GSTL-ITU/HORNET-RV32IMF/docs/figures/bootloader.pdf

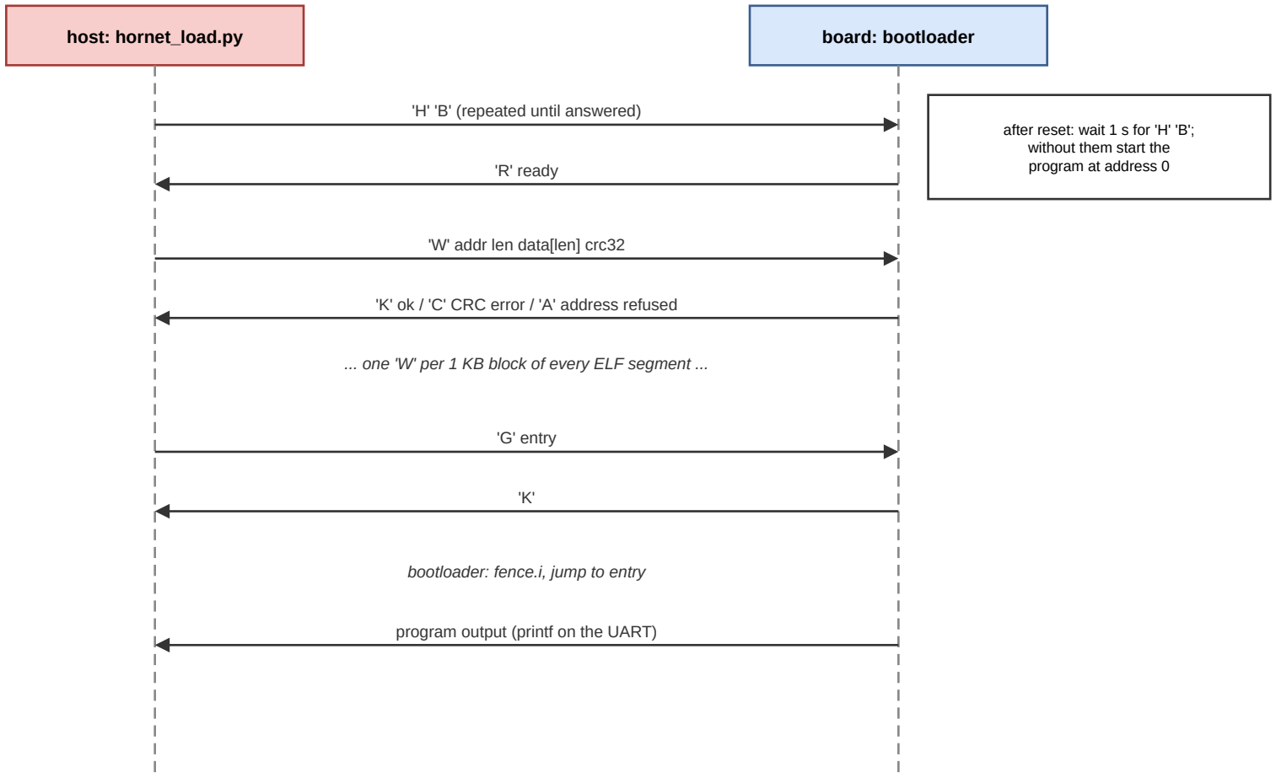
[picture p1: figure]
host: hornet_load.py; board: bootloader; 'H' 'B' (repeated until answered); 'R' ready; 'W' addr len data[len] crc32; 'G' entry; bootloader: fence.i, jump to entry; program output (printf on the UART); after reset: wait 1 s for 'H' 'B'; without them start the program at address 0

'K' ok / 'C' CRC error / 'A' address refused

... one 'W' per 1 KB block of every ELF segment ...
