GSTL-ITU/HORNET-RV32IMF/docs/figures/bus.pdf

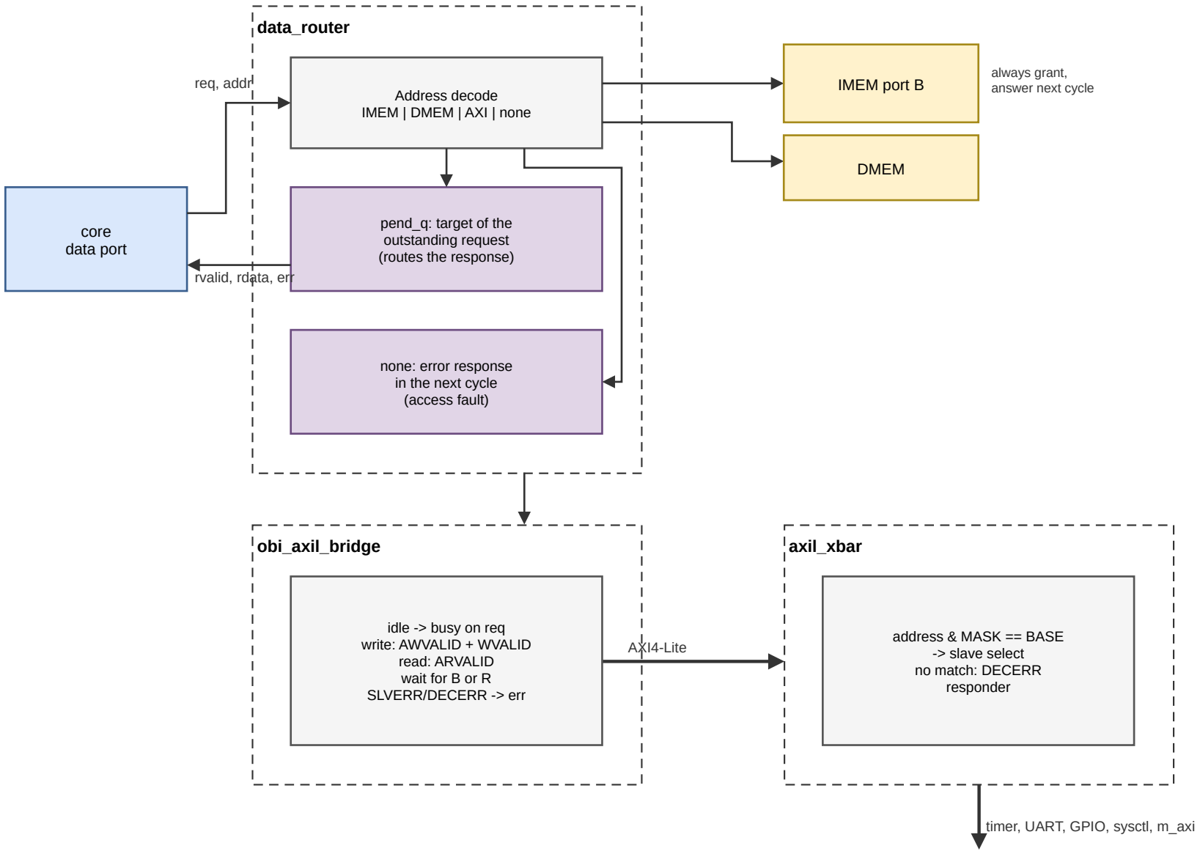
[picture p2: figure]
core data port; data_router; Address decode IMEM | DMEM | AXI | none; pend_q: target of the outstanding request (routes the response); none: error response in the next cycle (access fault); req, addr; rvalid, rdata, err; IMEM port B; DMEM; always grant, answer next cycle; obi_axil_bridge; idle -> busy on req write: AWVALID + WVALID read: ARVALID wait for B or R SLVERR/DECERR -> err; AXI4-Lite; axil_xbar; address & MASK == BASE -> slave select no match: DECERR responder; timer, UART, GPIO, sysctl, m_axi
