GSTL-ITU/HORNET-RV32IMF/docs/figures/cosim.pdf

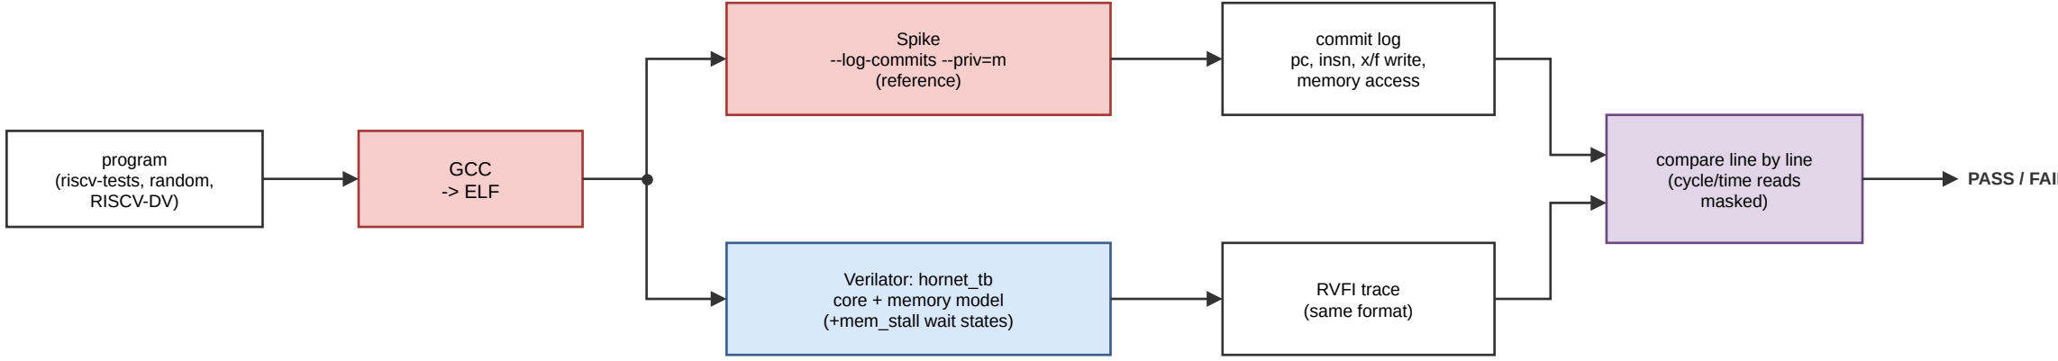
[picture p3: figure]
ris; m, RISCV-DV); pik; mit; riv; rila; el (+mem_stall wait states ); mit lo; rit; e lin; y lin; cle; tim

# e, memory access RVFI trace (same format)

I

L
