GSTL-ITU/HORNET-RV32IMF/docs/figures/memmap.pdf

IMEM (IMEM_SIZE)
.text, .rodata; bootloader in the top 4 KB

0x0000_0000

unmapped: access fault

DMEM (DMEM_SIZE)
.data, .sdata, .bss, heap, stack (top)

0x1000_0000

unmapped: access fault

timer (CLINT): msip, mtimecmp, mtime

0x2000_0000

UART: DATA, STATUS, CTRL, DIV

0x2001_0000

GPIO: OUT, IN, DIR, IE, IP, EDGE

0x2002_0000

system control: EXIT, CLK_FREQ, ID, SCRATCH

0x2003_0000

unmapped: DECERR -> access fault

external AXI4-Lite port (m_axi) up to 0x7FFF_FFFF

0x4000_0000

unmapped: access fault
0xFFFF_FFFF

instruction port: IMEM only data port: everything
