GSTL-ITU/HORNET-RV32IMF/docs/figures/swflow.pdf

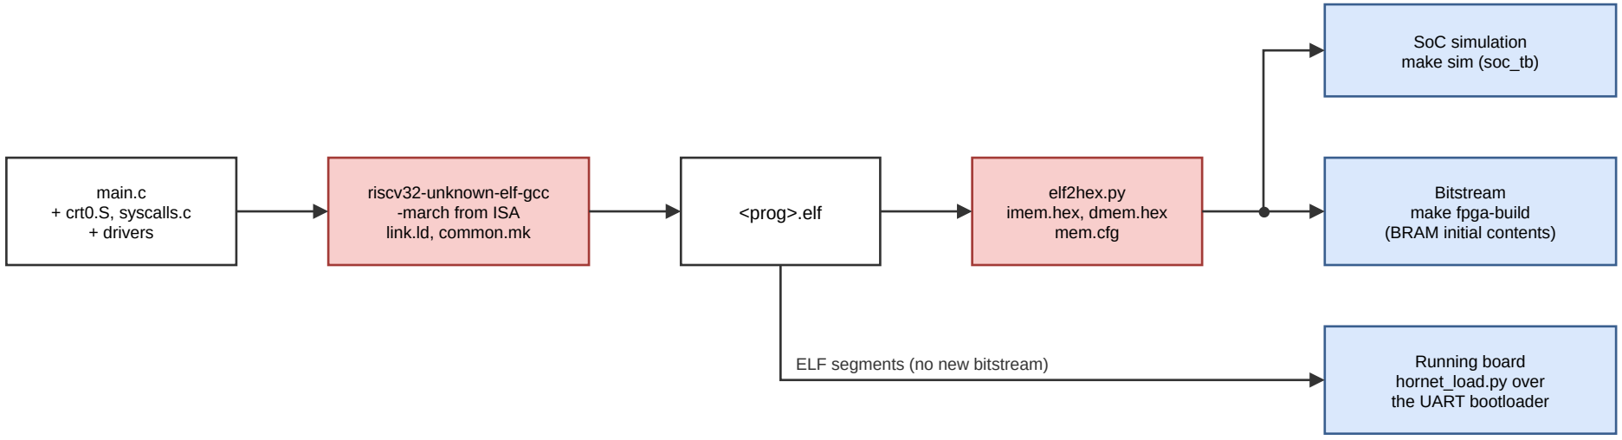
[picture p4: figure]
main.c + crt0.S, syscalls.c + drivers; riscv32-unknown-elf-gcc -march from ISA link.ld, common.mk; <prog>.elf; elf2hex.py imem.hex, dmem.hex mem.cfg; SoC simulation make sim (soc_tb); Bitstream make fpga-build (BRAM initial contents); Running board hornet_load.py over the UART bootloader; ELF segments (no new bitstream)
