GSTL-ITU/HORNET-RV32IMF/docs/figures/decode.pdf

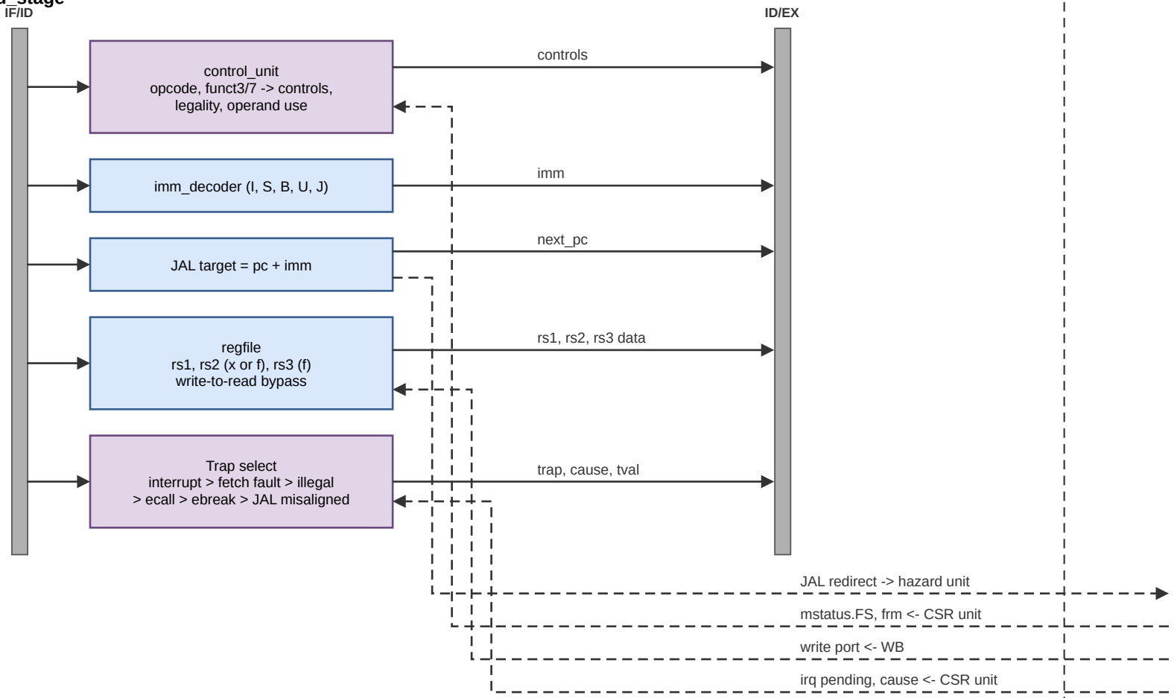
[picture p5: figure]
control_unit opcode, funct3/7 -> controls, legality, operand use; imm_decoder (I, S, B, U, J); JAL target = pc + imm; regfile rs1, rs2 (x or f), rs3 (f) write-to-read bypass; Trap select interrupt > fetch fault > illegal > ecall > ebreak > JAL misaligned; controls; imm; next_pc; rs1, rs2, rs3 data; trap, cause, tval; JAL redirect -> hazard unit; mstatus.FS, frm <- CSR unit; write port <- WB; irq pending, cause <- CSR unit

### id_stage
