GSTL-ITU/HORNET-RV32IMF/docs/figures/divider.pdf

### div (radix-2 restoring divider)

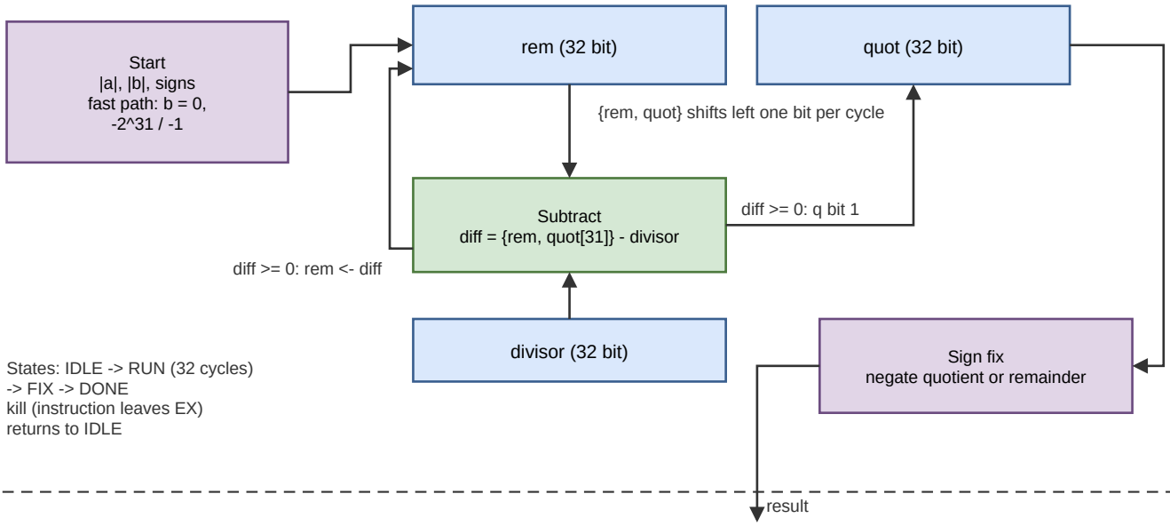
[picture p6: figure]
Start |a|, |b|, signs fast path: b = 0, -2^31 / -1; rem (32 bit); quot (32 bit); Subtract diff = {rem, quot[31]} - divisor; divisor (32 bit); diff >= 0: q bit 1; diff >= 0: rem <- diff; Sign fix negate quotient or remainder; result; States: IDLE -> RUN (32 cycles) -> FIX -> DONE kill (instruction leaves EX) returns to IDLE

{rem, quot} shifts left one bit per cycle
