GSTL-ITU/HORNET-RV32IMF/docs/figures/divsqrt.pdf

### fpu_divsqrt

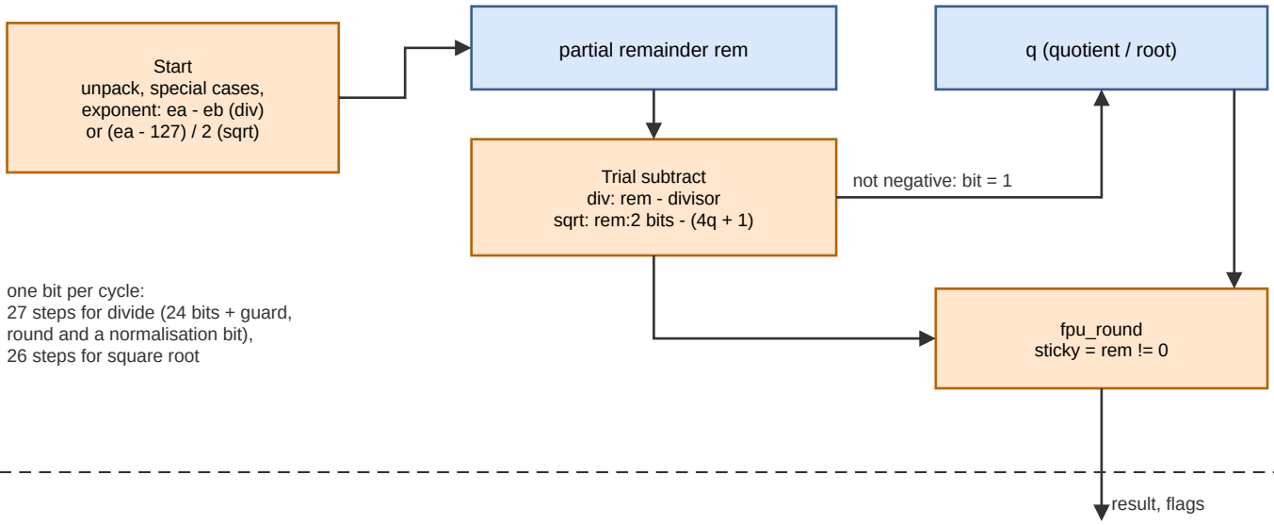
[picture p7: figure]
Start unpack, special cases, exponent: ea - eb (div) or (ea - 127) / 2 (sqrt); partial remainder rem; Trial subtract div: rem - divisor sqrt: rem:2 bits - (4q + 1); q (quotient / root); not negative: bit = 1; fpu_round sticky = rem != 0; result, flags; one bit per cycle: 27 steps for divide (24 bits + guard, round and a normalisation bit), 26 steps for square root
