GSTL-ITU/HORNET-RV32IMF/docs/figures/fma.pdf

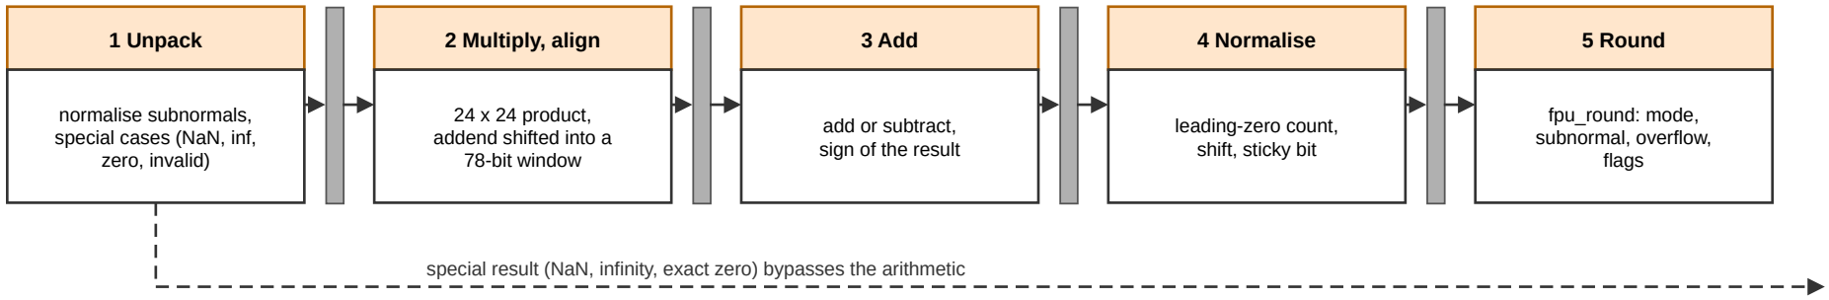
[picture p8: figure]
1 Unpack; normalise subnormals, special cases (NaN, inf, zero, invalid); 2 Multiply, align; 24 x 24 product, addend shifted into a 78-bit window; 3 Add; add or subtract, sign of the result; 4 Normalise; leading-zero count, shift, sticky bit; 5 Round; fpu_round: mode, subnormal, overflow, flags

special result (NaN, infinity, exact zero) bypasses the arithmetic op mapping: FADD a*1+b, FSUB a*1-b, FMUL a*b+(±0), FMADD a*b+c, FMSUB a*b-c, FNMSUB -a*b+c, FNMADD -a*b-c
