GSTL-ITU/HORNET-RV32IMF/docs/figures/periph.pdf

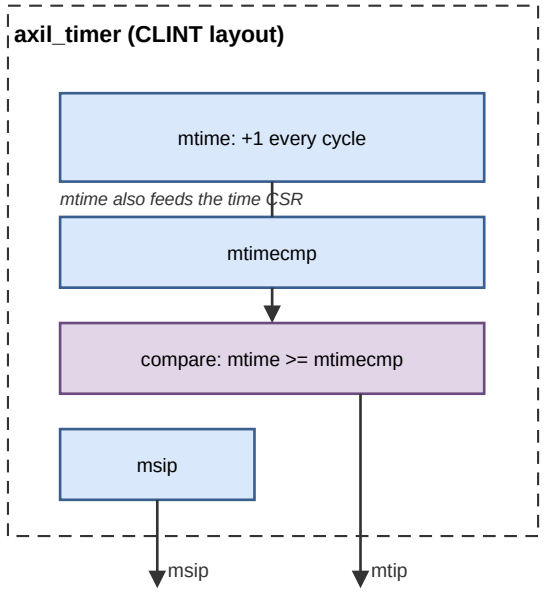
[picture p9: figure]
axil_timer (CLINT layout); mtime: +1 every cycle; mtimecmp; compare: mtime >= mtimecmp; msip; mtip; mtime also feeds the time CSR
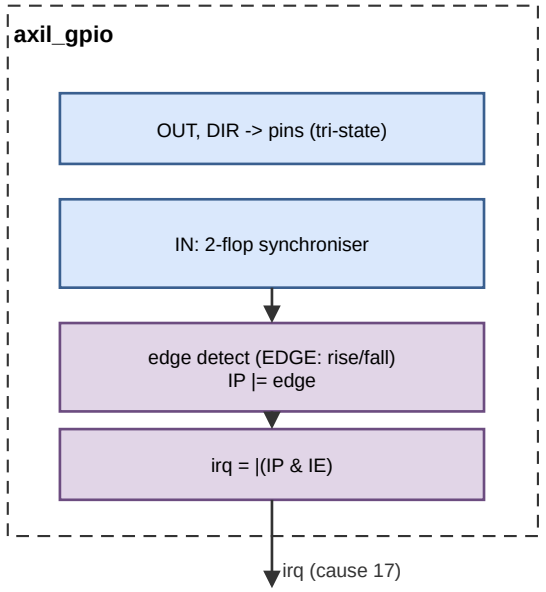
[picture p10: figure]
axil_gpio; OUT, DIR -> pins (tri-state); IN: 2-flop synchroniser; edge detect (EDGE: rise/fall) IP |= edge; irq = |(IP & IE); irq (cause 17)

axil_sysctl

EXIT -> exit_o, exit_code

CLK_FREQ (parameter)

ID = 0x4852_4E54 "HRNT"

SCRATCH
