GSTL-ITU/HORNET-RV32IMF/docs/manual.md

---
orphan: true
---

<!-- Root of the HORNET manual: Part I of the student's manual (make docs).
     The chapter list is the same as Part I in index.md. -->

# HORNET RV32IMF manual

```{toctree}
:maxdepth: 2
:numbered:

introduction
quick-start
repository
soc
core
programming
peripherals
software
fpga
verification
reference
references
```
