GSTL-ITU/HORNET-RV32IMF/docs/figures/blockdesign.pdf

### bd_demo (Vivado block design)

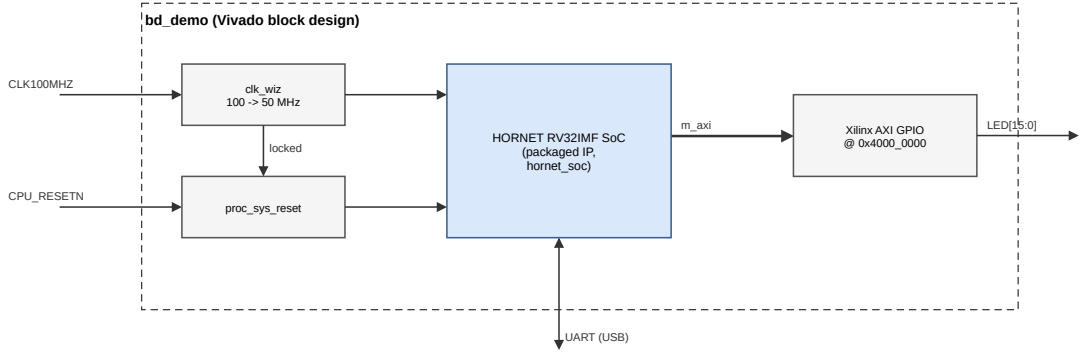
[picture p11: page 1]
clk_wiz 100 -> 50 MHz; proc_sys_reset; HORNET RV32IMF SoC (packaged IP, hornet_soc); locked; m_axi; LED[15:0]; UART (USB); CLK100MHZ; CPU_RESETN

Xilinx AXI GPIO
