GSTL-ITU/HORNET-RV32IMF/docs/figures/testbenches.pdf

t

b

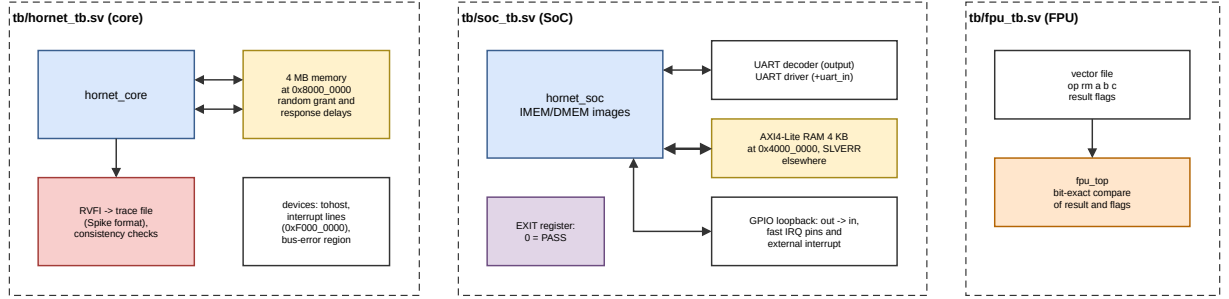
[picture p12: page 1]
ela; file; pik; ), consistency chec k; vic; t, interrupt lines; riv; Lit; els; PIO lo; XIT; gis; r: 0 = PASS; ult; fla; bit

c IMEM/DMEM im

> in, fast IRQ pins and external interrupt

), bus-error region
