GSTL-ITU/HORNET-RV32IMF/docs/figures/board.pdf

### hornet_board (FPGA top)

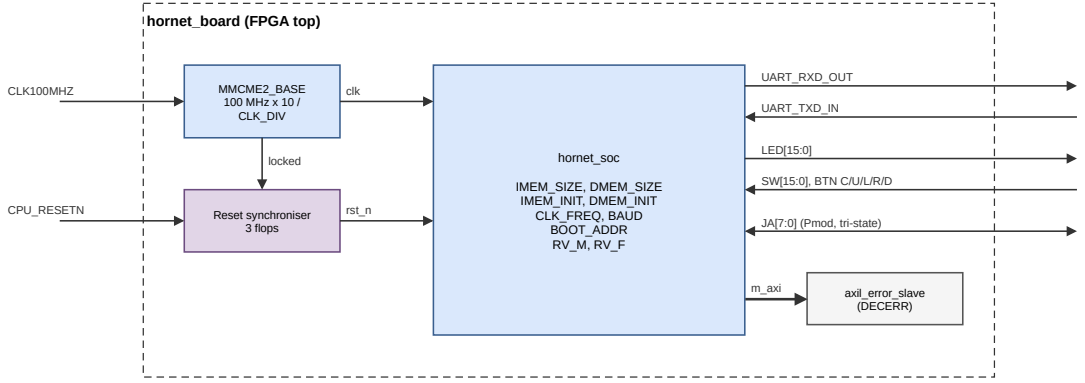
[picture p13: page 1]
MMCME2_BASE 100 MHz x 10 / CLK_DIV; CLK100MHZ; Reset synchroniser 3 flops; CPU_RESETN; locked; hornet_soc; IMEM_SIZE, DMEM_SIZE IMEM_INIT, DMEM_INIT CLK_FREQ, BAUD BOOT_ADDR RV_M, RV_F; clk; rst_n; axil_error_slave (DECERR); m_axi; UART_RXD_OUT; UART_TXD_IN; LED[15:0]; SW[15:0], BTN C/U/L/R/D

JA[7:0] (Pmod, tri-state)
