GSTL-ITU/HORNET-RV32IMF/docs/figures/fetch.pdf

### if_stage

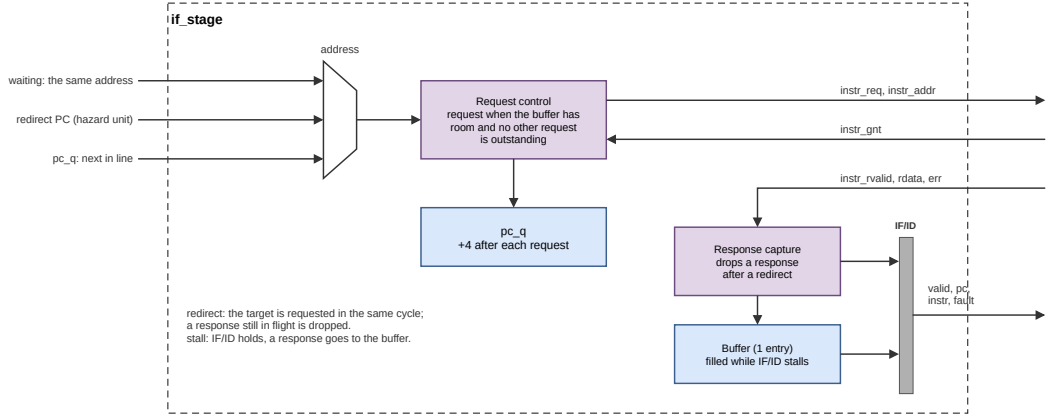
[picture p14: page 1]
address; instr_req, instr_addr; instr_gnt; +4 after each request; Response capture; drops a response after a redirect; instr_rvalid, rdata, err; valid, pc, instr, fault

waiting: the same address

Request control
request when the buffer has
room and no other request
is outstanding

redirect PC (hazard unit)

pc_q: next in line

redirect: the target is requested in the same cycle;
a response still in flight is dropped.
stall: IF/ID holds, a response goes to the buffer.

Buffer (1 entry)
filled while IF/ID stalls
