GSTL-ITU/HORNET-RV32IMF/docs/figures/pipeline.pdf

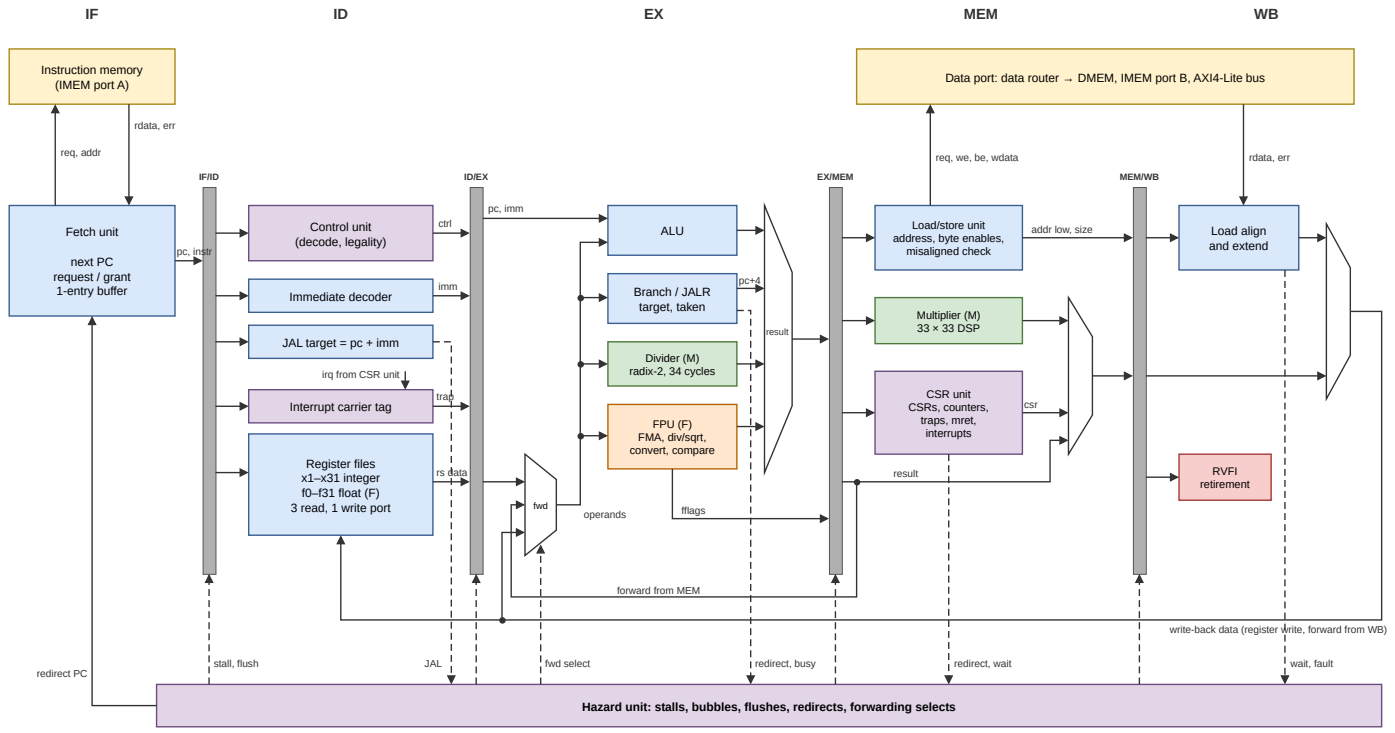
[picture p15: page 1]
MEM; Instruction memory (IMEM port A); Fetch unit; next PC request / grant 1-entry buffer; req, addr; rdata, err; pc, instr; Control unit (decode, legality); Immediate decoder; ctrl; imm; trap; rs data; fwd; ALU; Branch / JALR target, taken; Divider (M) radix-2, 34 cycles; pc, imm; operands; result; EX/MEM; fflags; redirect, busy; Multiplier (M) 33 × 33 DSP; CSR unit CSRs, counters, traps, mret, interrupts; csr; MEM/WB; redirect, wait; Load align and extend; RVFI retirement; wait, fault; JAL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

Data port: data router → DMEM, IMEM port B, AXI4-Lite bus

req, we, be, wdata

Load/store unit
address, byte enables,
misaligned check

addr low, size

JAL target = pc + imm

irq from CSR unit

Interrupt carrier tag

FPU (F)
FMA, div/sqrt,
convert, compare

Register files
x1–x31 integer
f0–f31 float (F)
3 read, 1 write port

forward from MEM

write-back data (register write, forward from WB)

Hazard unit: stalls, bubbles, flushes, redirects, forwarding selects
