GSTL-ITU/HORNET-RV32IMF/docs/figures/riscvdv.pdf

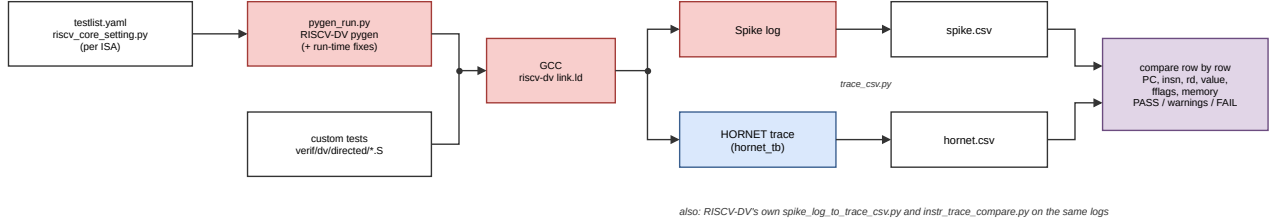
[picture p16: page 1]
testlist.yaml riscv_core_setting.py (per ISA); Spike log; HORNET trace (hornet_tb); spike.csv; hornet.csv; trace_csv.py

pygen_run.py
RISCV-DV pygen
(+ run-time fixes)

GCC
riscv-dv link.ld

compare row by row
PC, insn, rd, value,
fflags, memory
PASS / warnings / FAIL

custom tests
verif/dv/directed/*.S

also: RISCV-DV's own spike_log_to_trace_csv.py and instr_trace_compare.py on the same logs
