GSTL-ITU/HORNET-RV32IMF/docs/figures/soc.pdf

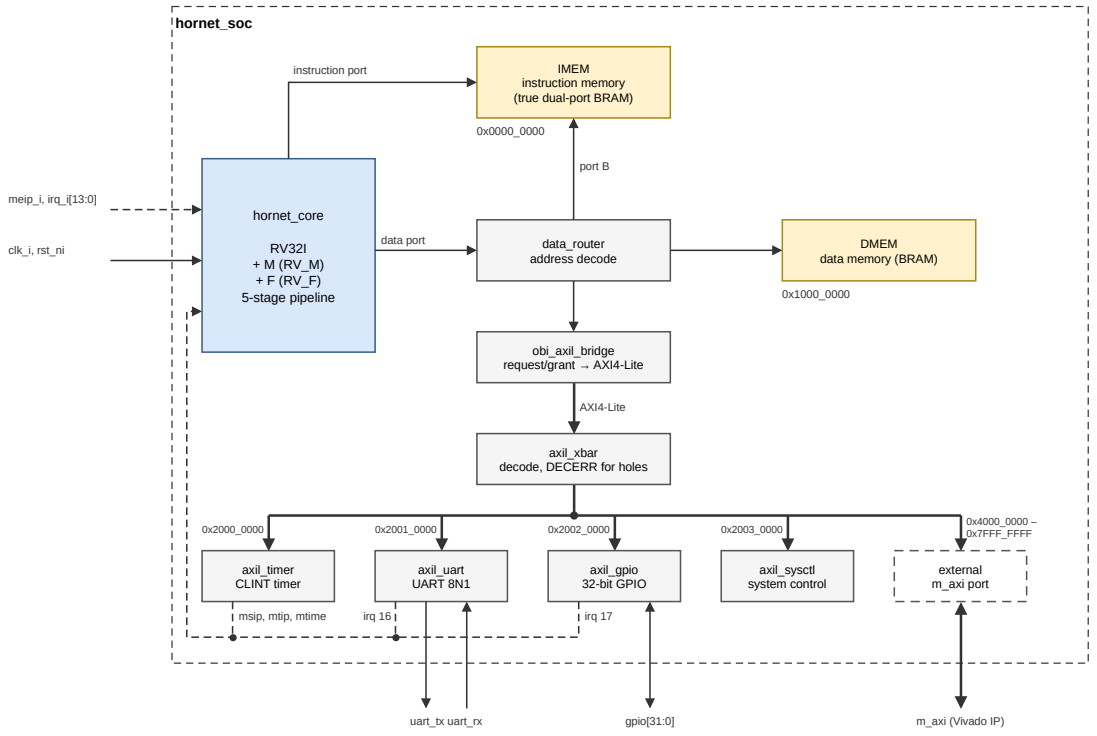
[picture p17: page 1]
hornet_soc; hornet_core; RV32I + M (RV_M) + F (RV_F) 5-stage pipeline; instruction port; data_router address decode; data port; port B; axil_xbar; AXI4-Lite; axil_timer CLINT timer; axil_uart UART 8N1; axil_gpio 32-bit GPIO; axil_sysctl system control; external m_axi port; uart_tx uart_rx; gpio[31:0]; m_axi (Vivado IP); msip, mtip, mtime; irq 16; irq 17; meip_i, irq_i[13:0]; clk_i, rst_ni; 0x4000_0000 – 0x7FFF_FFFF

IMEM
instruction memory
(true dual-port BRAM)

DMEM
data memory (BRAM)

obi_axil_bridge
request/grant → AXI4-Lite

decode, DECERR for holes
