GSTL-ITU/HORNET-RV32IMF/docs/figures/uart.pdf

### axil_uart

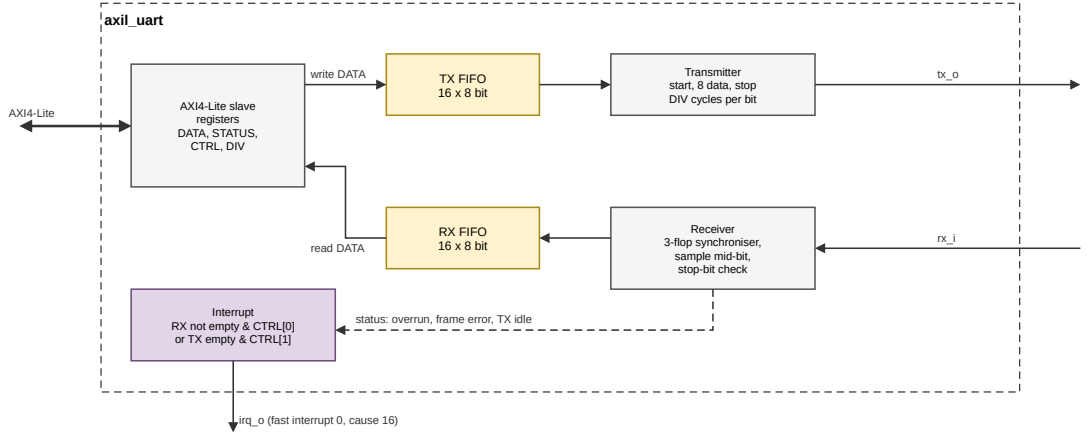
[picture p19: page 1]
AXI4-Lite slave registers DATA, STATUS, CTRL, DIV; AXI4-Lite; TX FIFO 16 x 8 bit; write DATA; RX FIFO 16 x 8 bit; read DATA; Interrupt

Transmitter
start, 8 data, stop
DIV cycles per bit

Receiver
3-flop synchroniser,
sample mid-bit,
stop-bit check

status: overrun, frame error, TX idle

RX not empty & CTRL[0]
or TX empty & CTRL[1]

irq_o (fast interrupt 0, cause 16)
