GSTL-ITU/HORNET-RV32IMF/docs/figures/core_rv32i.pdf

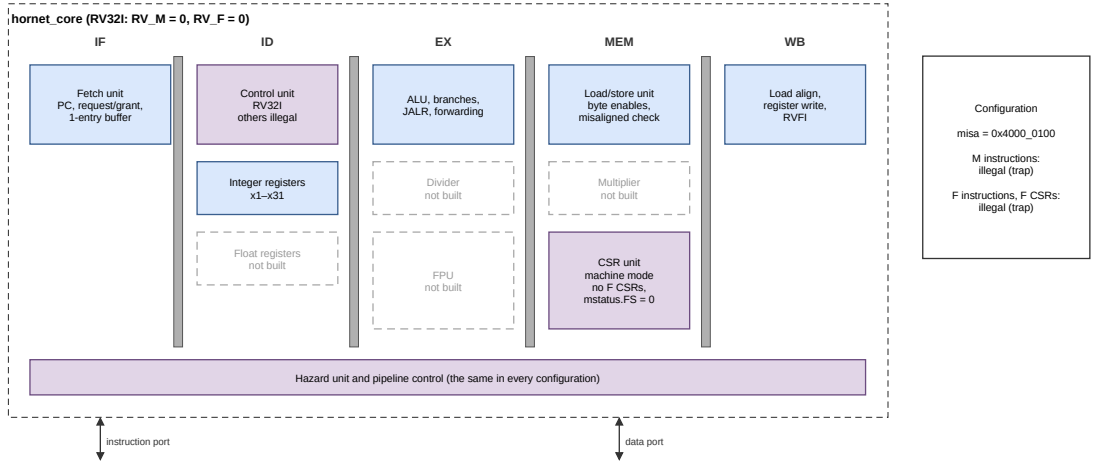
[picture p20: page 1]
hornet_core (RV32I: RV_M = 0, RV_F = 0); MEM; Control unit RV32I others illegal; Integer registers x1–x31; Float registers not built; ALU, branches, JALR, forwarding; Divider not built; FPU not built; Multiplier not built; CSR unit machine mode no F CSRs, mstatus.FS = 0; Load align, register write, RVFI; Configuration; misa = 0x4000_0100; M instructions: illegal (trap); F instructions, F CSRs: illegal (trap); instruction port; data port

Fetch unit
PC, request/grant,
1-entry buffer

Load/store unit
byte enables,
misaligned check

Hazard unit and pipeline control (the same in every configuration)
