GSTL-ITU/HORNET-RV32IMF/docs/figures/core_rv32imf.pdf

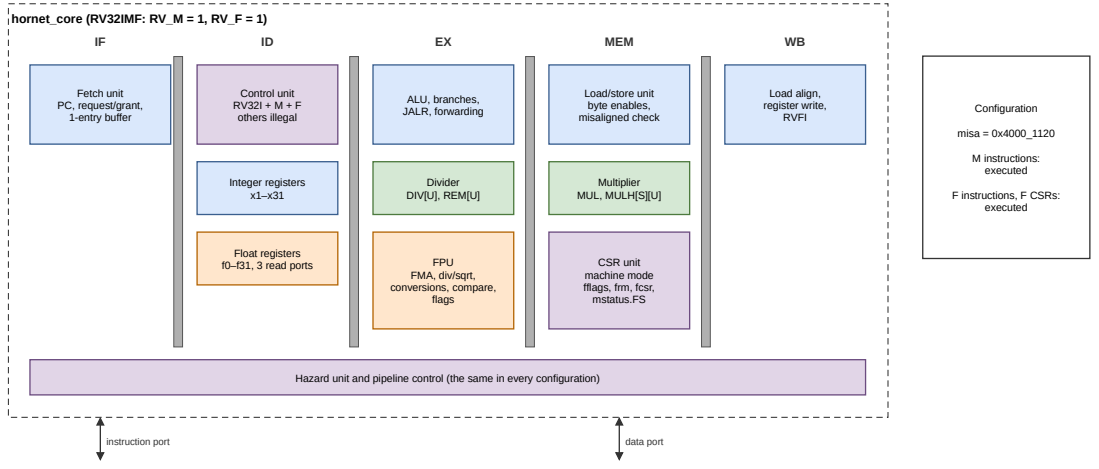
[picture p22: page 1]
hornet_core (RV32IMF: RV_M = 1, RV_F = 1); MEM; Control unit RV32I + M + F others illegal; Integer registers x1–x31; Float registers f0–f31, 3 read ports; ALU, branches, JALR, forwarding; Divider DIV[U], REM[U]; flags; Multiplier MUL, MULH[S][U]; Load align, register write, RVFI; Configuration; misa = 0x4000_1120; M instructions: executed; F instructions, F CSRs: executed; instruction port; data port

Fetch unit
PC, request/grant,
1-entry buffer

Load/store unit
byte enables,
misaligned check

FPU
FMA, div/sqrt,
conversions, compare,

CSR unit
machine mode
fflags, frm, fcsr,
mstatus.FS

Hazard unit and pipeline control (the same in every configuration)
