GSTL-ITU/HORNET-RV32IMF/docs/figures/csr.pdf

### csr_unit

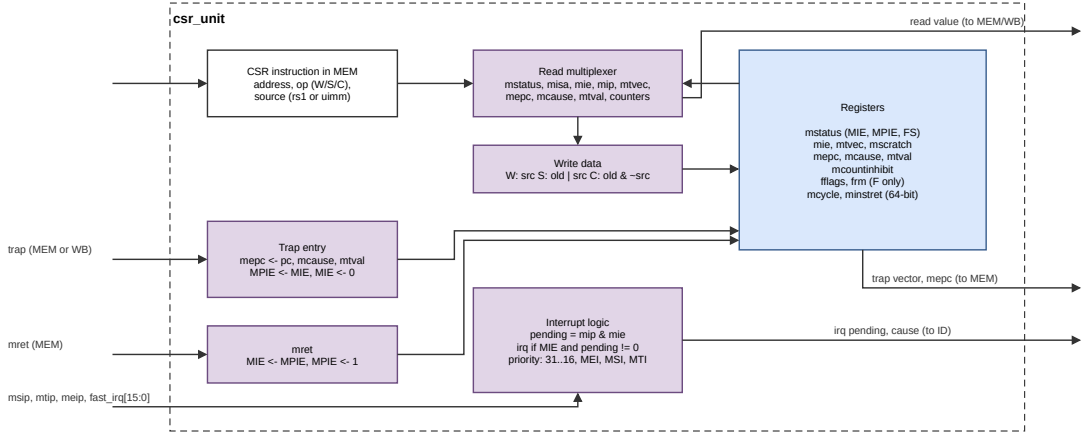
[picture p23: page 1]
Write data; Registers; Trap entry; mret; mret (MEM)

read value (to MEM/WB)

CSR instruction in MEM
address, op (W/S/C),
source (rs1 or uimm)

Read multiplexer
mstatus, misa, mie, mip, mtvec,
mepc, mcause, mtval, counters

mstatus (MIE, MPIE, FS)
mie, mtvec, mscratch
mepc, mcause, mtval
mcountinhibit
fflags, frm (F only)
mcycle, minstret (64-bit)

W: src S: old | src C: old & ~src

trap (MEM or WB)

mepc <- pc, mcause, mtval
MPIE <- MIE, MIE <- 0

trap vector, mepc (to MEM)

Interrupt logic
pending = mip & mie
irq if MIE and pending != 0
priority: 31..16, MEI, MSI, MTI

irq pending, cause (to ID)

MIE <- MPIE, MPIE <- 1

msip, mtip, meip, fast_irq[15:0]
