GSTL-ITU/HORNET-RV32IMF/docs/figures/environment.pdf

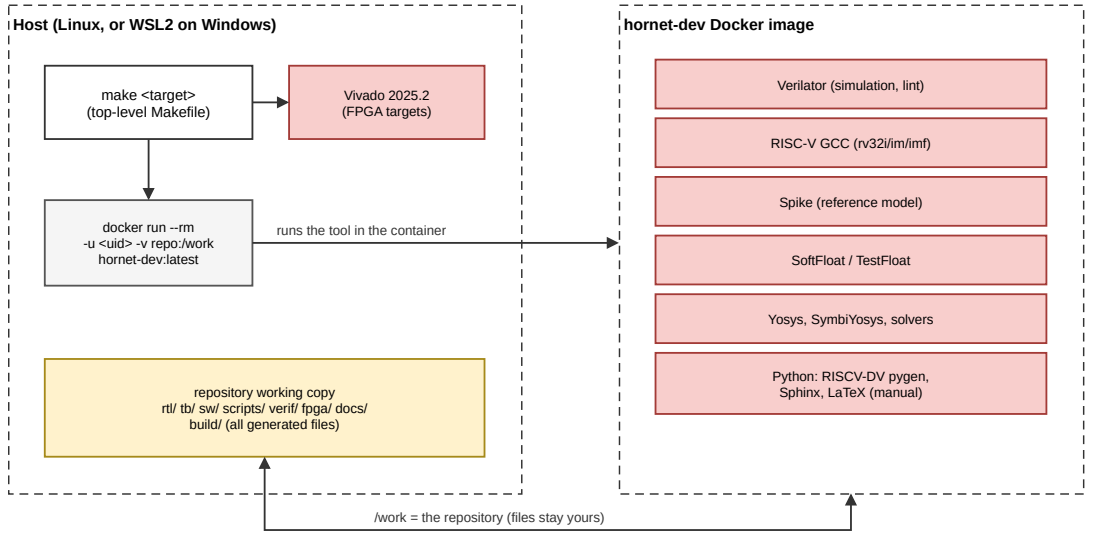
[picture p24: page 1]
Vivado 2025.2 (FPGA targets); SoftFloat / TestFloat

Host (Linux, or WSL2 on Windows)

hornet-dev Docker image

make <target>
(top-level Makefile)

Verilator (simulation, lint)

RISC-V GCC (rv32i/im/imf)

Spike (reference model)

docker run --rm
-u <uid> -v repo:/work
hornet-dev:latest

runs the tool in the container

Yosys, SymbiYosys, solvers

Python: RISCV-DV pygen,
Sphinx, LaTeX (manual)

repository working copy
rtl/ tb/ sw/ scripts/ verif/ fpga/ docs/
build/ (all generated files)

/work = the repository (files stay yours)
