GSTL-ITU/HORNET-RV32IMF/docs/figures/execute.pdf

### ex_stage

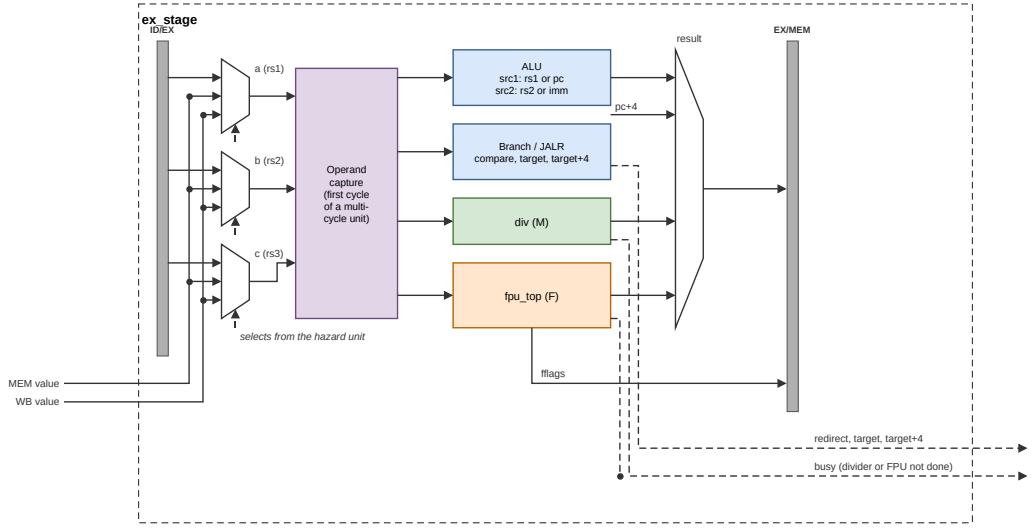
[picture p25: page 1]
MEM value; WB value; Operand capture (first cycle of a multi- cycle unit); ALU src1: rs1 or pc src2: rs2 or imm; div (M); fpu_top (F); result; EX/MEM; fflags

Branch / JALR
compare, target, target+4

selects from the hazard unit

redirect, target, target+4

busy (divider or FPU not done)
