GSTL-ITU/HORNET-RV32IMF/docs/figures/formal.pdf

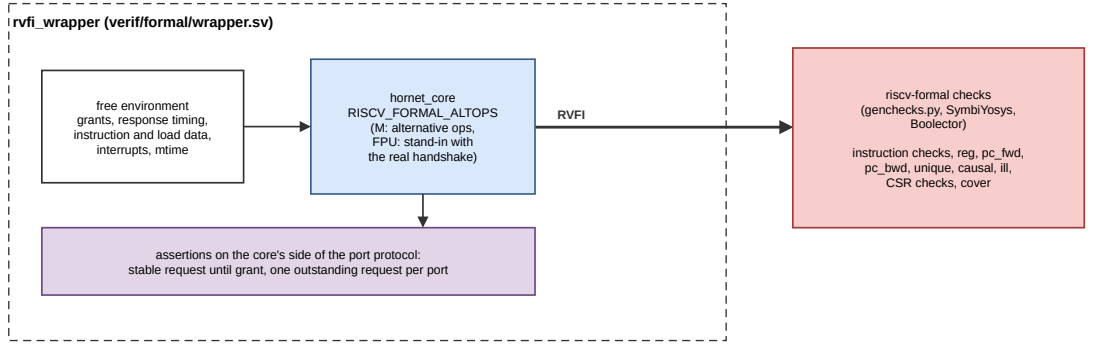
[picture p26: page 1]
hornet_core; RVFI; Boolector)

rvfi_wrapper (verif/formal/wrapper.sv)

riscv-formal checks
(genchecks.py, SymbiYosys,

free environment
grants, response timing,
instruction and load data,
interrupts, mtime

RISCV_FORMAL_ALTOPS
(M: alternative ops,
FPU: stand-in with
the real handshake)

instruction checks, reg, pc_fwd,
pc_bwd, unique, causal, ill,
CSR checks, cover

assertions on the core's side of the port protocol:
stable request until grant, one outstanding request per port
