GSTL-ITU/HORNET-RV32IMF/docs/figures/fpu.pdf

f

p

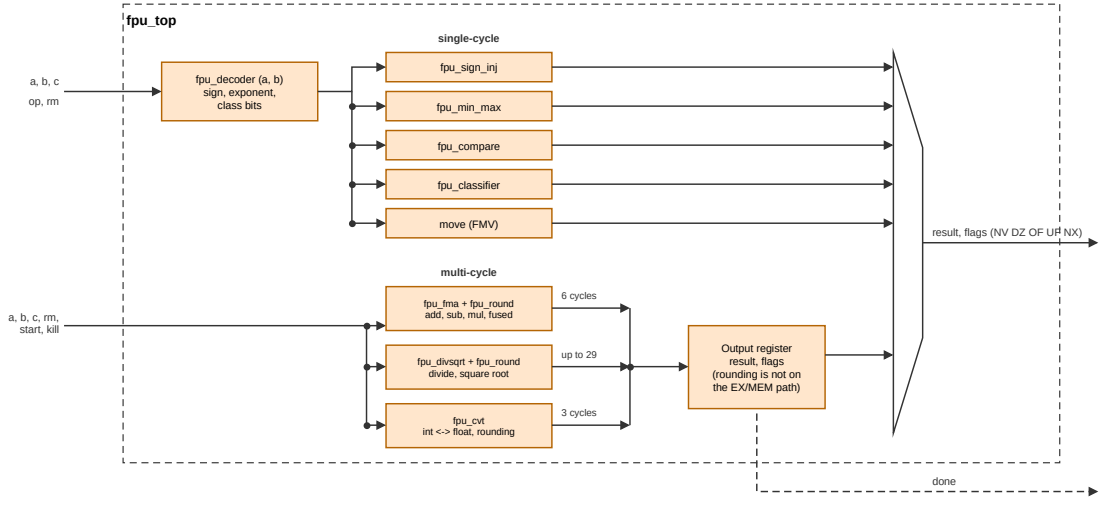
[picture p27: page 1]
sig; t, class bits; min; cla; sifie; cle; div; divid; din; m, start, kill; gis; ult, fla

t int <-> float, ro
