GSTL-ITU/HORNET-RV32IMF/docs/figures/memwb.pdf

### mem_stage and wb_stage

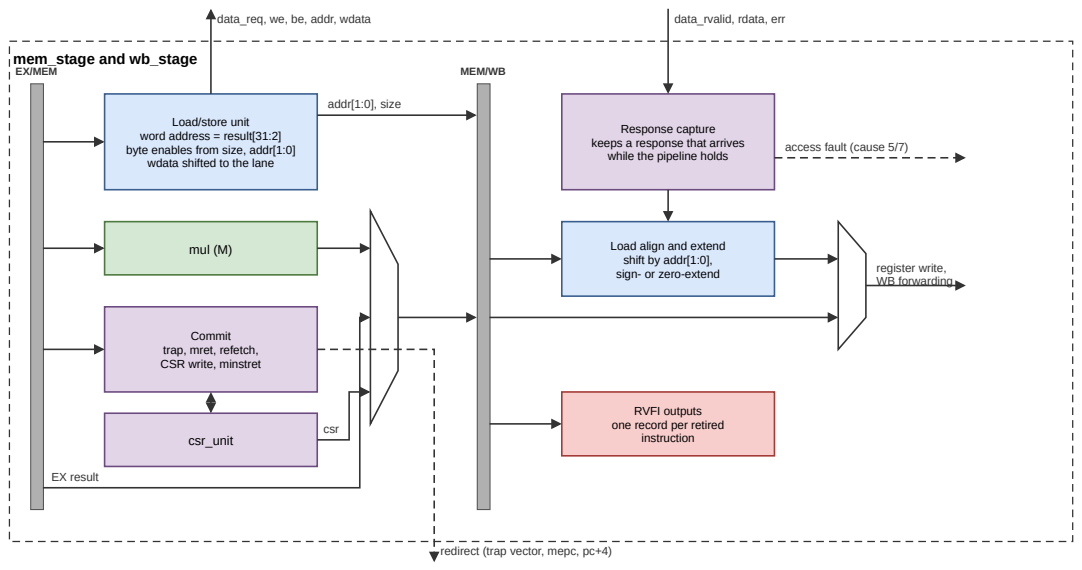
[picture p28: page 1]
EX/MEM; mul (M); csr_unit; csr; EX result; MEM/WB; addr[1:0], size; data_rvalid, rdata, err; register write, WB forwarding

data_req, we, be, addr, wdata

Load/store unit
word address = result[31:2]
byte enables from size, addr[1:0]
wdata shifted to the lane

Response capture
keeps a response that arrives
while the pipeline holds

access fault (cause 5/7)

Load align and extend
shift by addr[1:0],
sign- or zero-extend

Commit
trap, mret, refetch,
CSR write, minstret

RVFI outputs
one record per retired
instruction

redirect (trap vector, mepc, pc+4)
