GSTL-ITU/HORNET-RV32IMF/docs/figures/rounding.pdf

### fpu_round

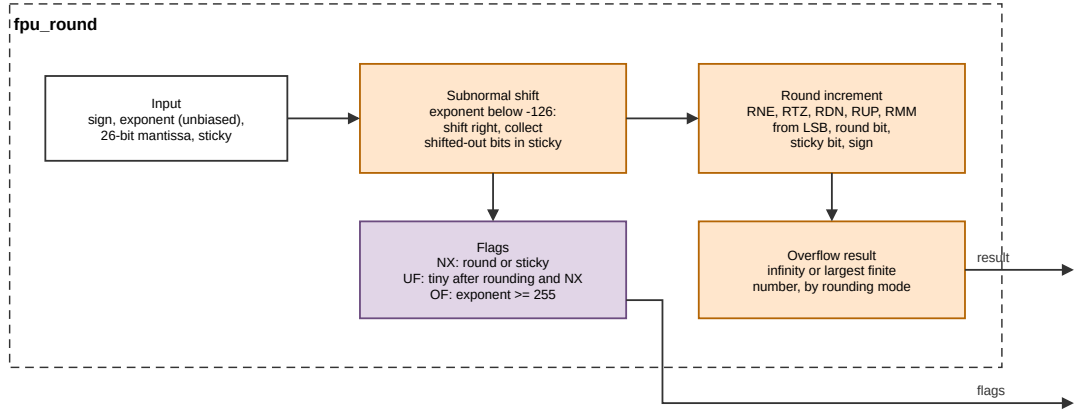
[picture p29: page 1]
Input; result; flags

Subnormal shift
exponent below -126:
shift right, collect
shifted-out bits in sticky

Round increment
RNE, RTZ, RDN, RUP, RMM
from LSB, round bit,
sticky bit, sign

sign, exponent (unbiased),
26-bit mantissa, sticky

Flags
NX: round or sticky
UF: tiny after rounding and NX
OF: exponent >= 255

Overflow result
infinity or largest finite
number, by rounding mode
