GSTL-ITU/HORNET-RV32IMF/(commit log)

2026-09-28 Bugfix: Bootloader removed from the topmodule to avoid being implemented on FPGA. loader_reset is intentionally removed, since the loader FSM resets the core whenever the UART sees 0x2D, 0x5F*, 0x70.
2026-11-01 HORNET version 2.0.0
    A rework of the whole design on top of version 1.2.0 (branch legacy).
    - core: five-stage in-order pipeline with one hazard unit, forwarding of
    integer and float registers, precise traps; ISA configurations RV32I,
    RV32IM and RV32IMF through the RV_M/RV_F parameters
    - fpu: IEEE 754 binary32 with fused multiply-add, iterative divide and
    square root, all rounding modes, subnormals and flags
    - csr: full machine-mode CSR set, vectored mtvec, 16 fast interrupts
    - soc: Harvard instruction/data block RAMs, OBI-style core ports, AXI4-Lite
    interconnect with CLINT timer, UART with FIFOs, 32-bit GPIO, system
    control and an external AXI4-Lite master port
    - sw: startup code,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
2026-11-02 docs: regression and coverage badges; code coverage in the manual
    README: Regression (GitHub Actions) and Codecov badges.
    verification: the GitHub workflows, a code coverage section with the
    results per ISA configuration. reference: coverage and docker-build-ci
    targets. repository: coverage files and directories, the stages of the
    tool image. changelog: 2026-11-02 entry.
